THEschildkrote/armtracking/markers_A4.pdf

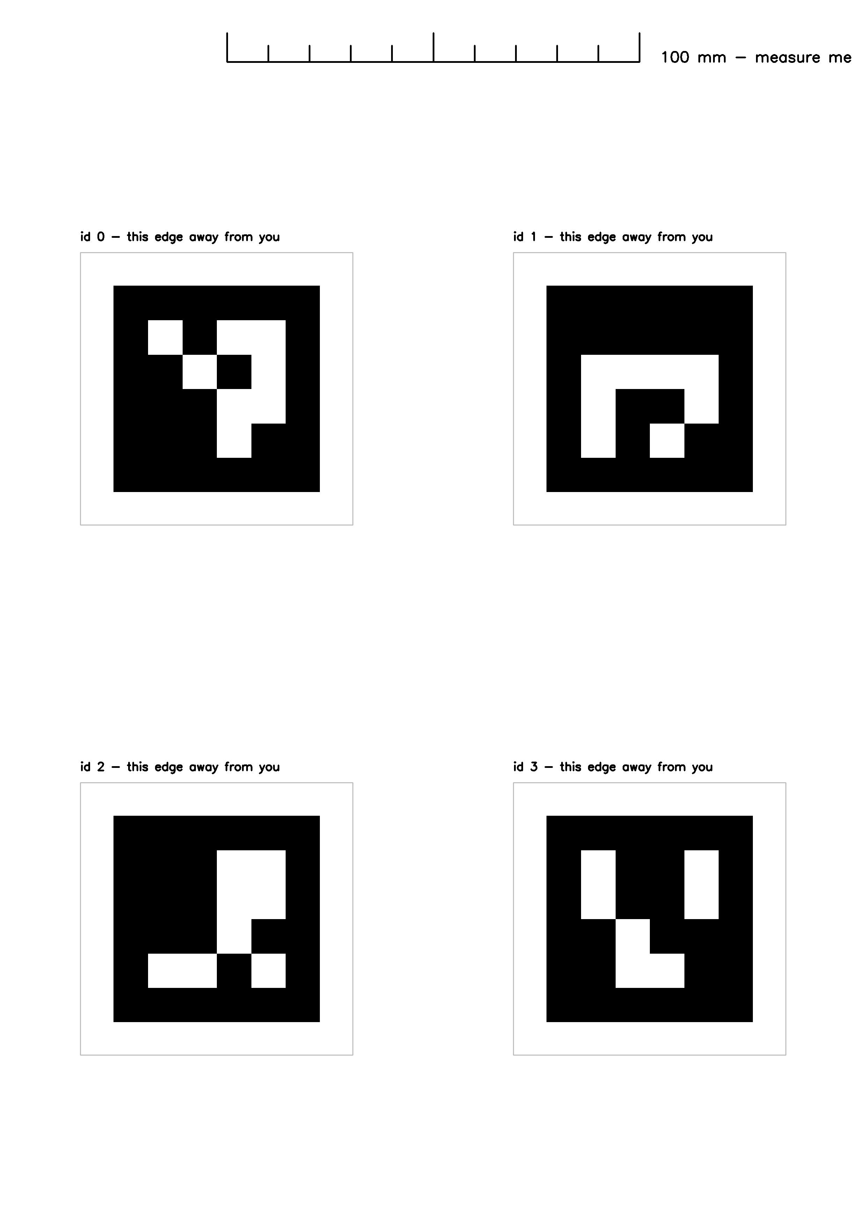
[picture p7: page 1]
