THEschildkrote/armtracking/data/2026-10-17/images/front_now.jpg

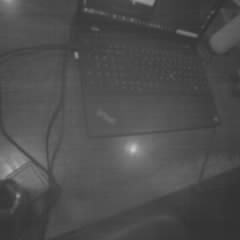
data/2026-10-17/images/front_now.jpg
