THEschildkrote/armtracking/data/2026-10-17/images/relay_eye.jpg

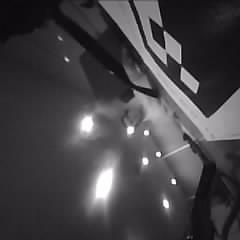
data/2026-10-17/images/relay_eye.jpg
