THEschildkrote/armtracking/data/2026-10-17/images/relay_wrist.jpg

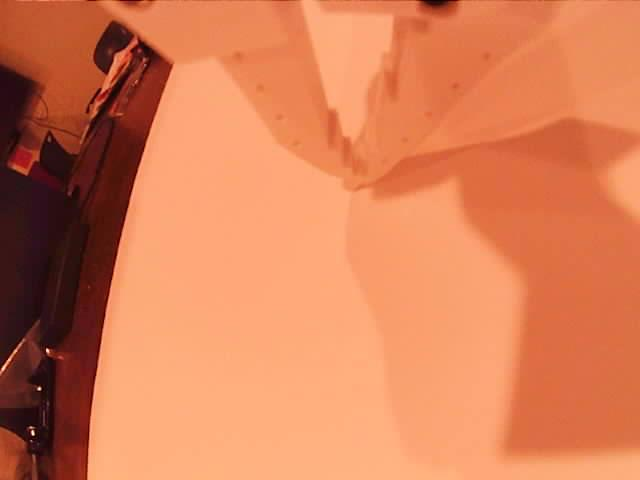
data/2026-10-17/images/relay_wrist.jpg
