THEschildkrote/armtracking/data/2026-10-17/images/side_ffmpeg.jpg

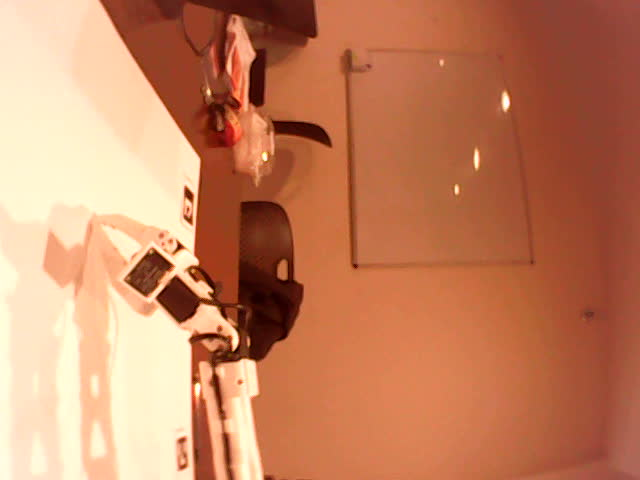
data/2026-10-17/images/side_ffmpeg.jpg
