THEschildkrote/armtracking/data/2026-10-17/images/side_live_objects.jpg

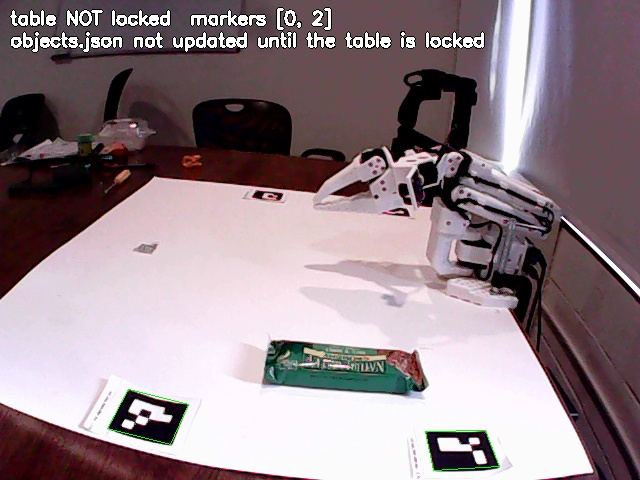
data/2026-10-17/images/side_live_objects.jpg
