THEschildkrote/armtracking/data/2026-10-17/images/side_reach_map.jpg

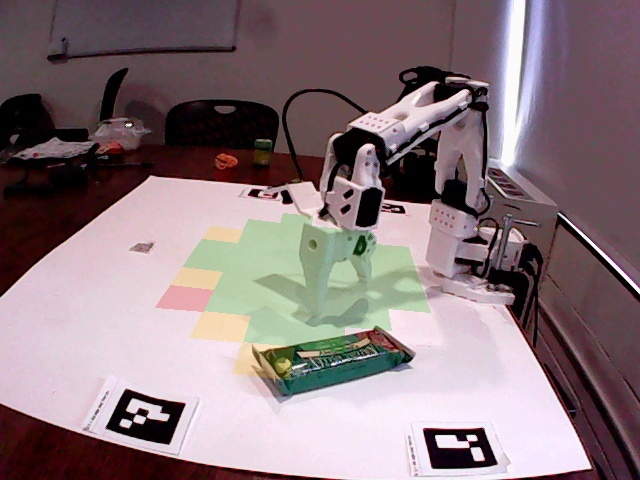
data/2026-10-17/images/side_reach_map.jpg
