THEschildkrote/armtracking/gaze/phone_target.png

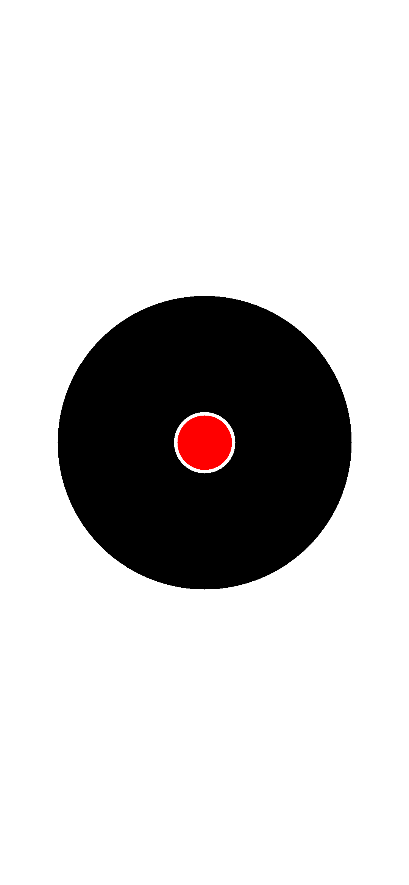
gaze/phone_target.png
