THEschildkrote/armtracking/output/figures/front_view.png

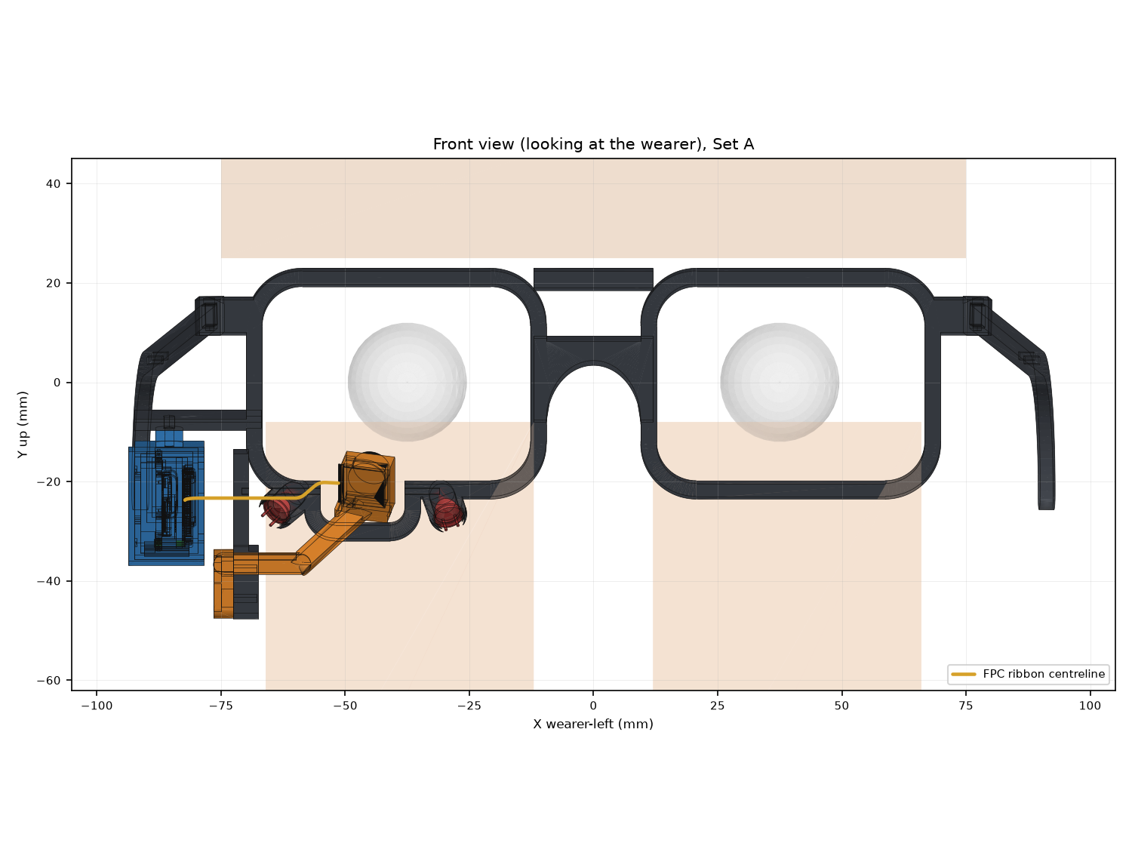
output/figures/front_view.png
