THEschildkrote/armtracking/output/figures/pivot_sweep_A.gif

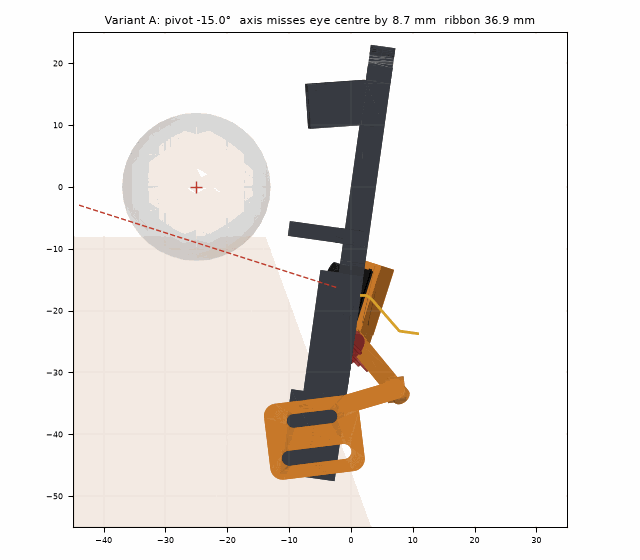
output/figures/pivot_sweep_A.gif
