THEschildkrote/armtracking/output/figures/side_view_A_dimensioned.png

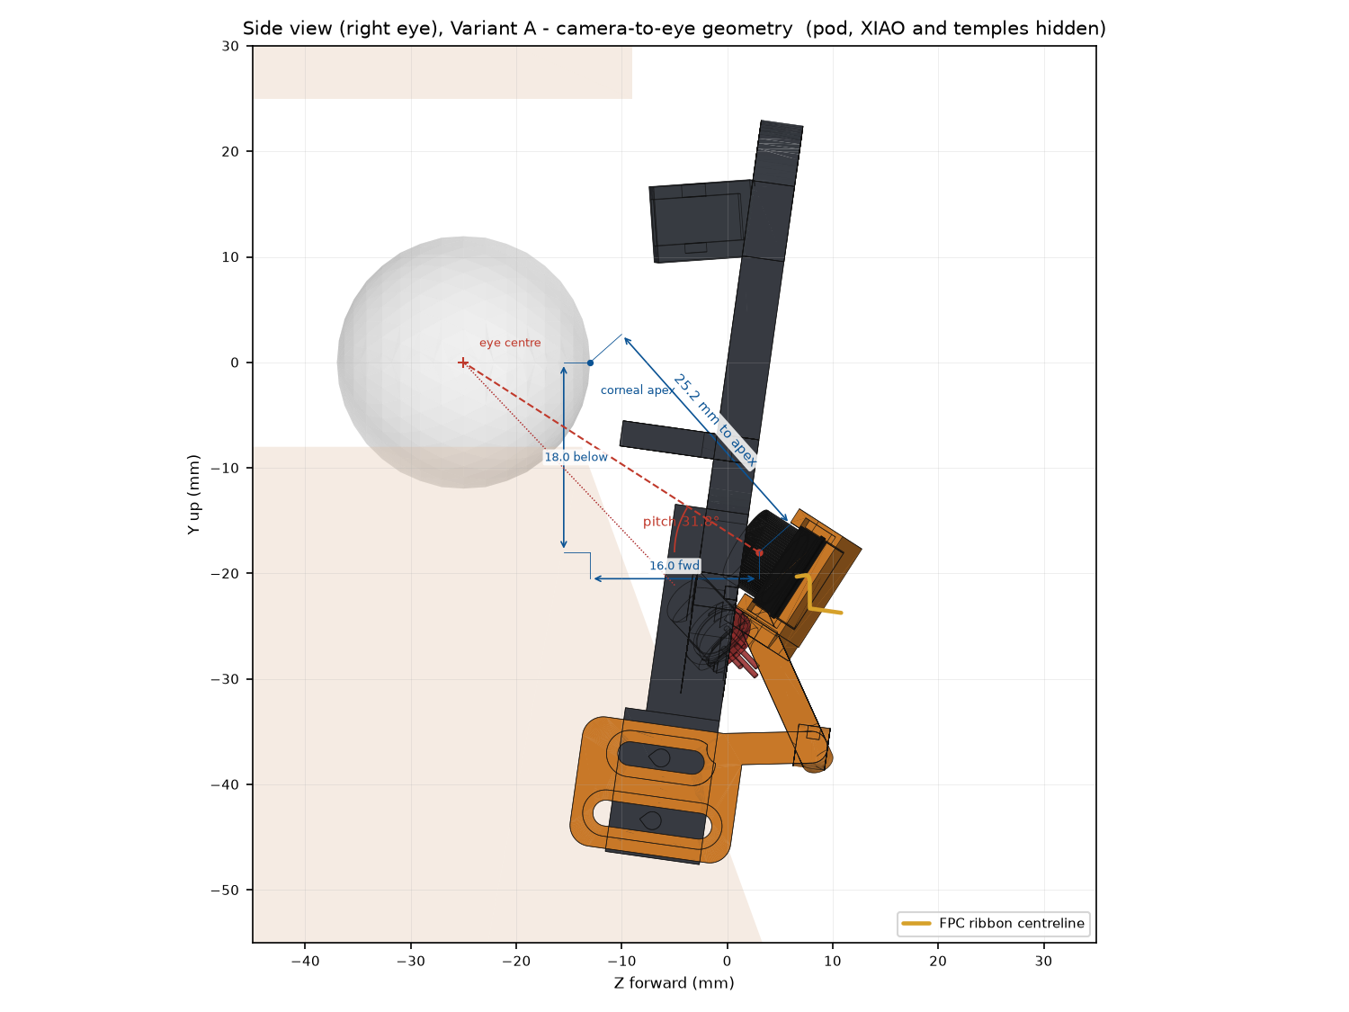
output/figures/side_view_A_dimensioned.png
