THEschildkrote/armtracking/output/figures/top_view.png

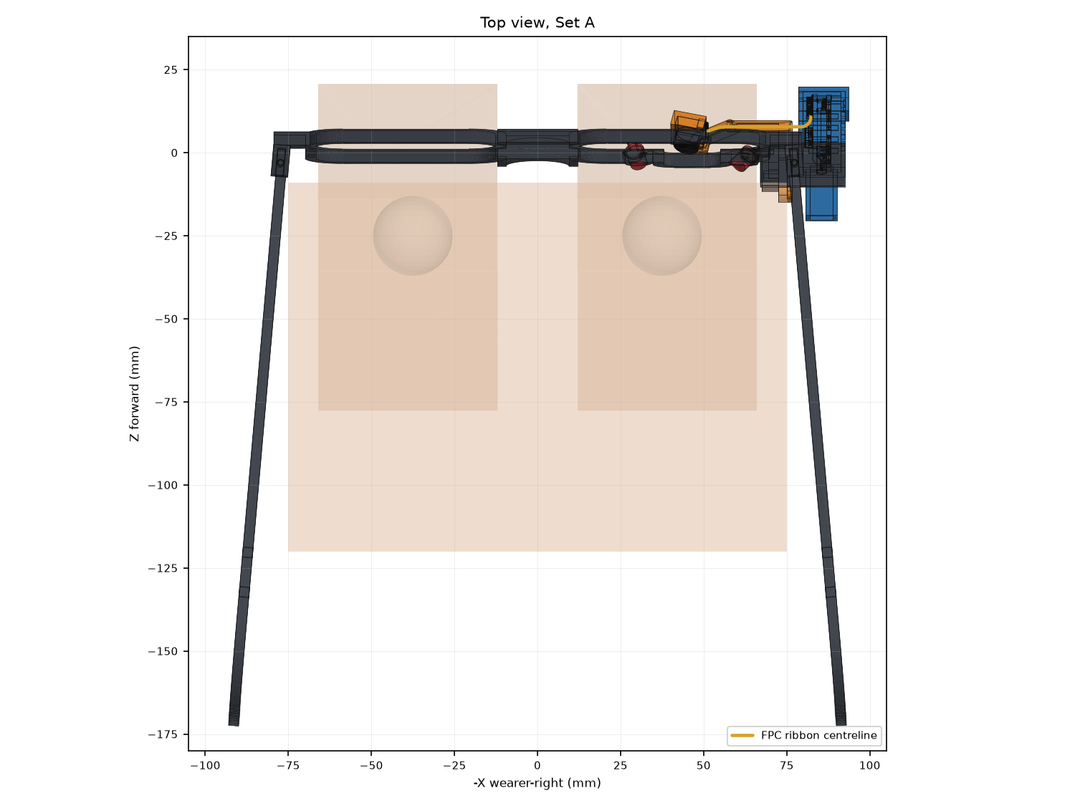
output/figures/top_view.png
