THEschildkrote/armtracking/output/figures/variant_comparison_A_vs_B.png

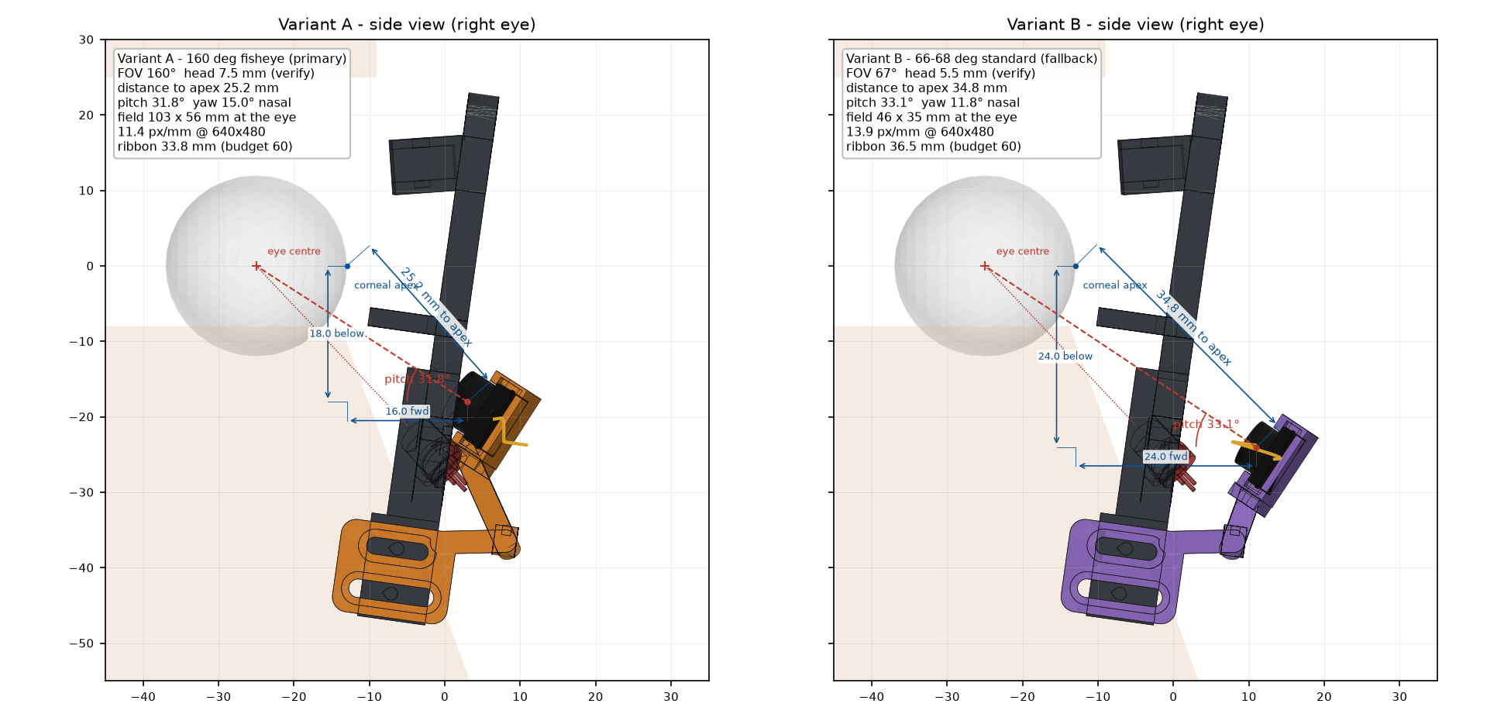
output/figures/variant_comparison_A_vs_B.png
