THEschildkrote/armtracking/output/assembly/eyetracker_set_B_assembly.step

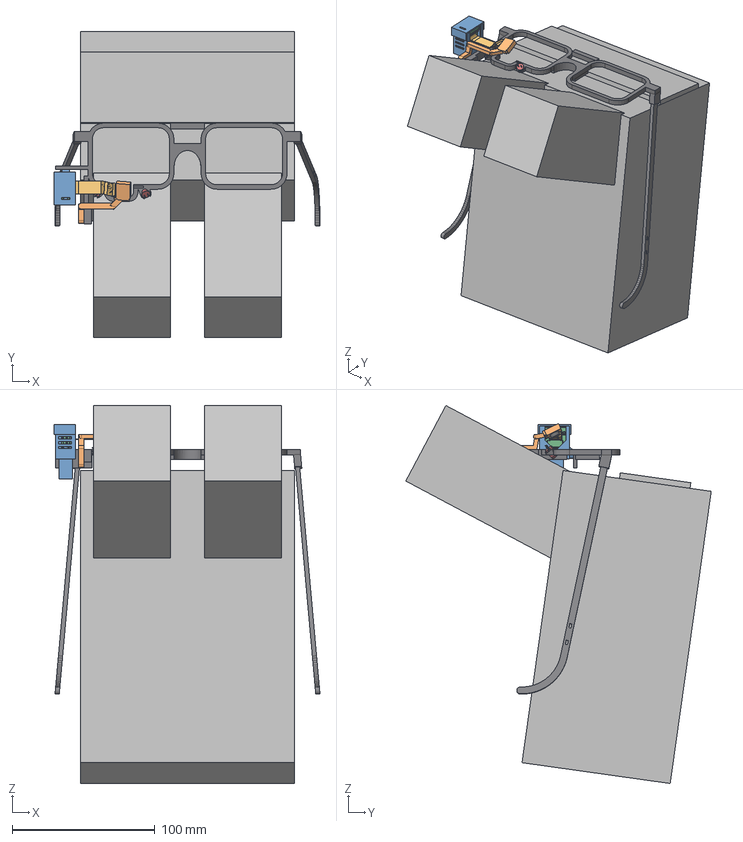
[picture p22: CAD file, 2026-10-17]
output/assembly/eyetracker_set_B_assembly.step
186.6 x 214.4 x 265.2 mm
front
temple_R
temple_L
pod_body
pod_lid
xiao_esp32s3_sense
ir_led_temporal
ir_led_nasal
stalk_B
camera_B
ribbon_B
eye_right
eye_left
cheek_right
cheek_left
brow
head
