THEschildkrote/armtracking/output/poses/variant_A_slot_fore_assembly.step

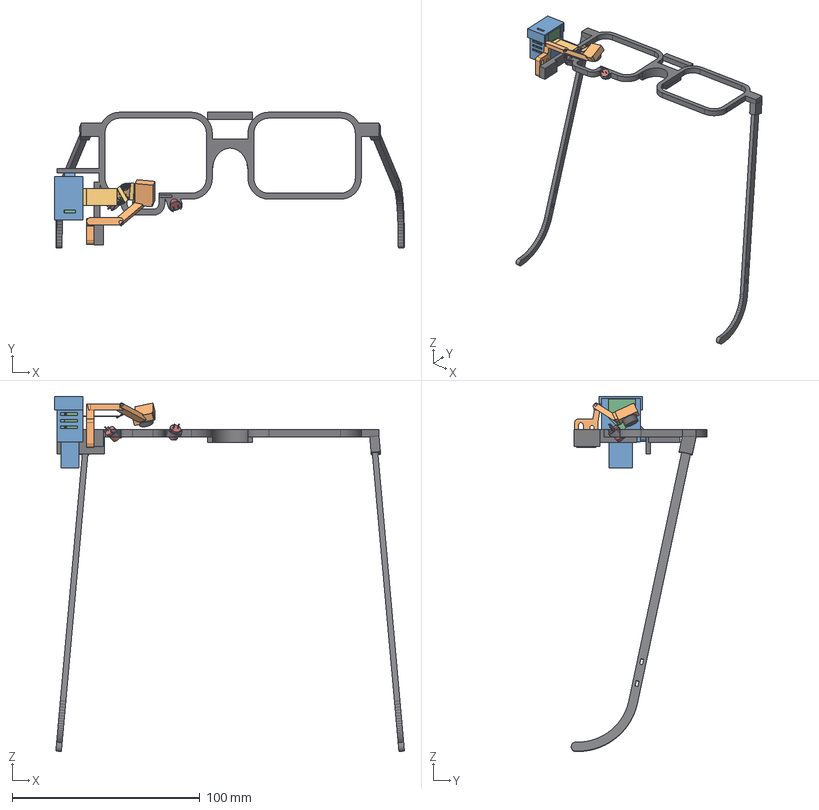
[picture p23: CAD file, 2026-10-17]
output/poses/variant_A_slot_fore_assembly.step
186.6 x 72.3 x 189.3 mm
front
temple_R
temple_L
pod_body
pod_lid
xiao_envelope_measured
ir_led_temporal
ir_led_nasal
stalk_A
camera_A
ribbon_A
