THEschildkrote/armtracking/output/print_orientation/pod_lid.step

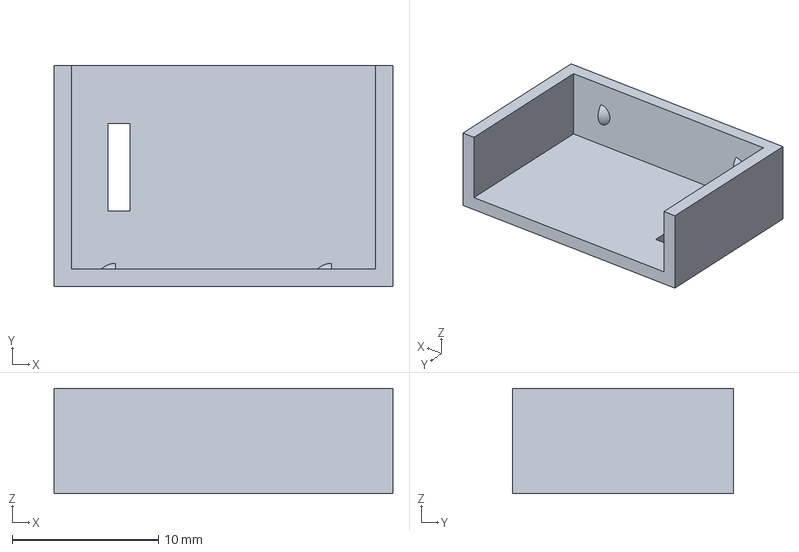
[picture p24: CAD file, 2026-10-17]
output/print_orientation/pod_lid.step
23.2 x 15.1 x 7.20 mm
