THEschildkrote/armtracking/output/print_sets/print_set_B_frame_plus_stalk_B.step

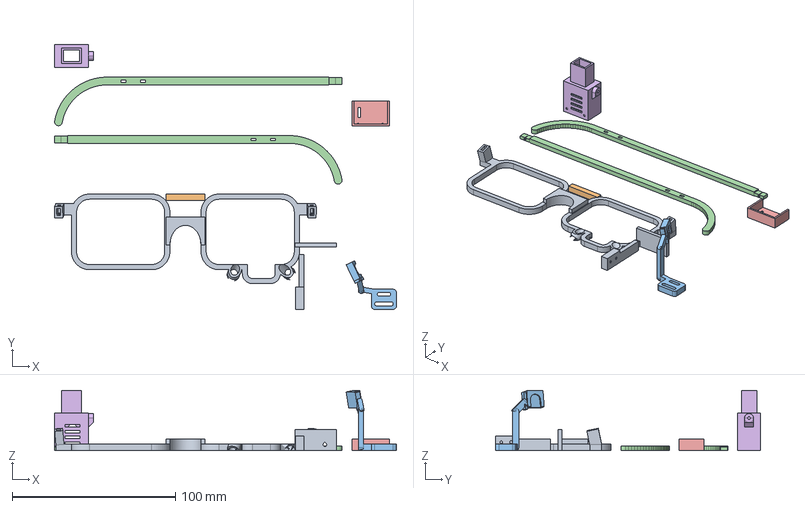
[picture p25: CAD file, 2026-10-17]
output/print_sets/print_set_B_frame_plus_stalk_B.step
209.6 x 162.3 x 37.1 mm
