THEschildkrote/armtracking/output/reference/camera_B_8p5_head_verify.step

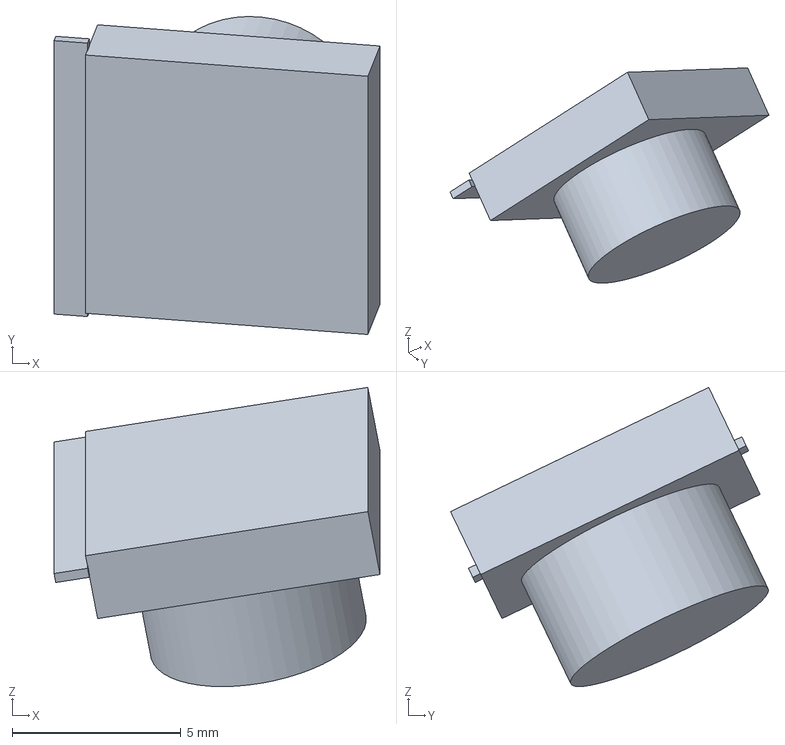
[picture p26: CAD file, 2026-10-17]
output/reference/camera_B_8p5_head_verify.step
9.67 x 9.43 x 8.88 mm
