THEschildkrote/armtracking/output/step/temple_left.step

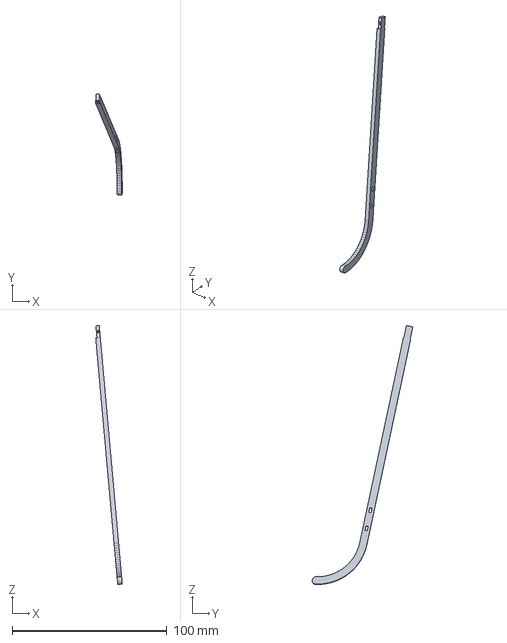
[picture p27: CAD file, 2026-10-17]
output/step/temple_left.step
17.2 x 65.0 x 167.3 mm
