THEschildkrote/armtracking/output/assembly/eyetracker_set_A_AS_WORN_world_frame_flat.step

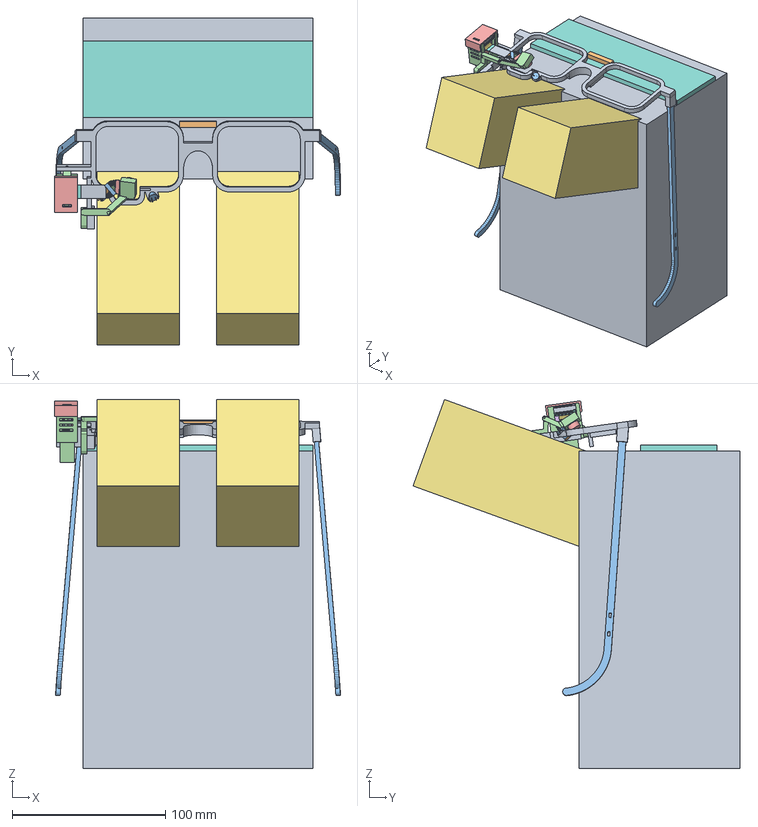
[picture p28: CAD file, 2026-10-17]
output/assembly/eyetracker_set_A_AS_WORN_world_frame_flat.step
186.6 x 213.3 x 240.7 mm
