THEschildkrote/armtracking/output/print_orientation/temple_right.step

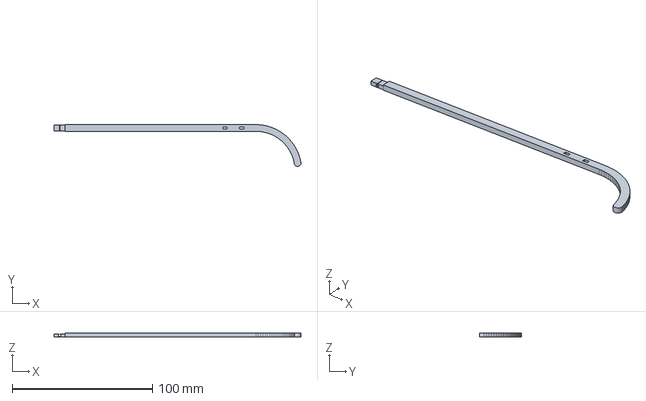
[picture p29: CAD file, 2026-10-17]
output/print_orientation/temple_right.step
176.2 x 29.8 x 3.00 mm
