THEschildkrote/armtracking/output/reference/xiao_esp32s3_sense_placed.step

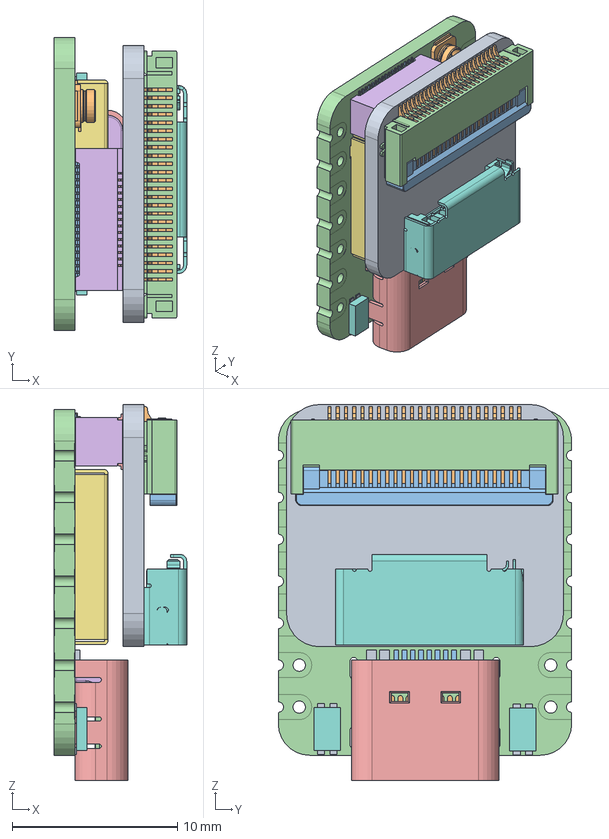
[picture p30: CAD file, 2026-10-17]
output/reference/xiao_esp32s3_sense_placed.step
8.03 x 17.8 x 22.8 mm
