THEschildkrote/armtracking/output/step/front.step

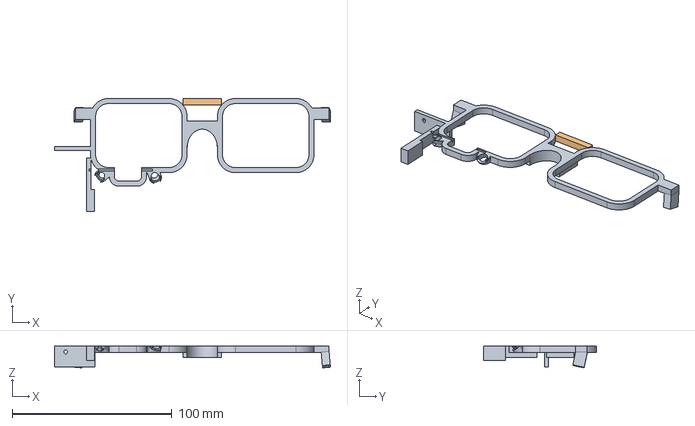
[picture p31: CAD file, 2026-10-17]
output/step/front.step
172.7 x 70.7 x 13.7 mm
