THEschildkrote/armtracking/output/reference/face_proxy.step

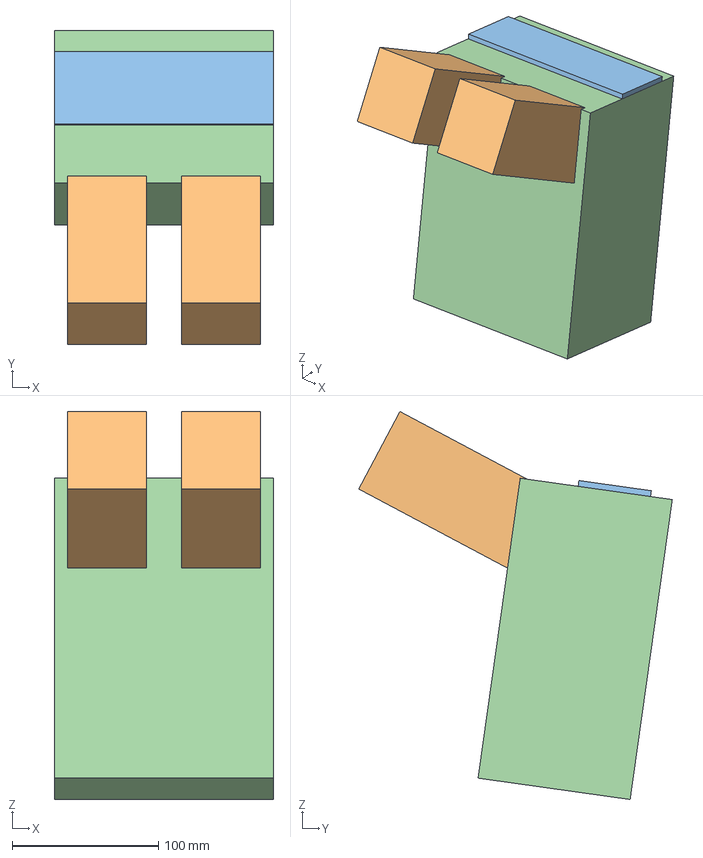
[picture p32: CAD file, 2026-10-17]
output/reference/face_proxy.step
150.0 x 214.4 x 265.2 mm
