THEschildkrote/armtracking/output/print_orientation/stalk_B.step

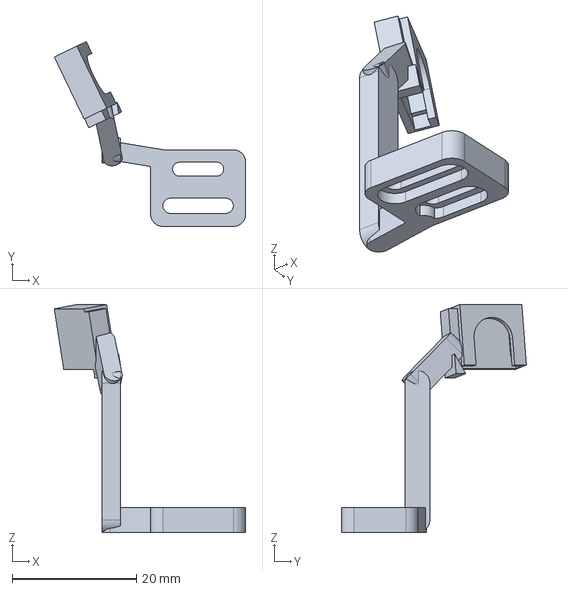
[picture p33: CAD file, 2026-10-17]
output/print_orientation/stalk_B.step
30.9 x 29.8 x 36.8 mm
