THEschildkrote/armtracking/output/reference/ir_led_nasal.step

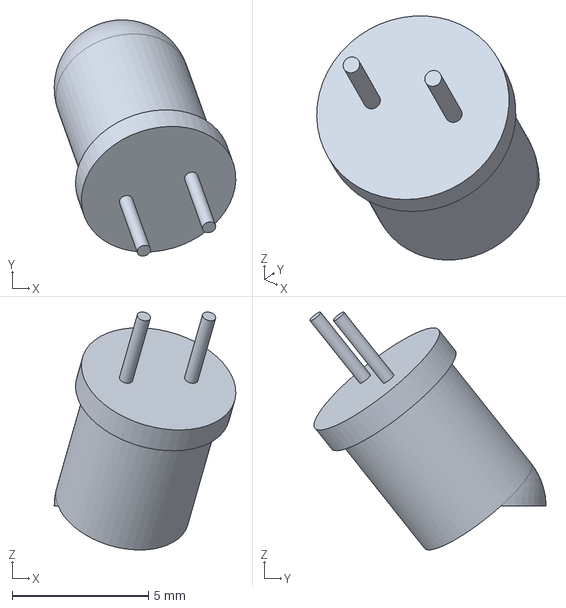
[picture p34: CAD file, 2026-10-17]
output/reference/ir_led_nasal.step
6.66 x 8.66 x 8.72 mm
