THEschildkrote/armtracking/output/step/pod_body.step

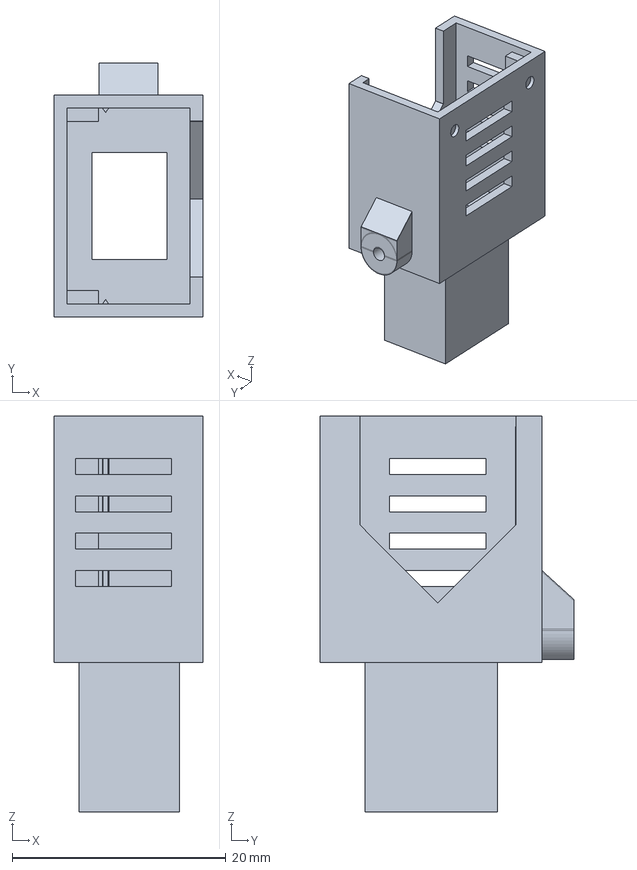
[picture p35: CAD file, 2026-10-17]
output/step/pod_body.step
13.9 x 23.8 x 37.1 mm
