THEschildkrote/armtracking/output/print_orientation/stalk_A.step

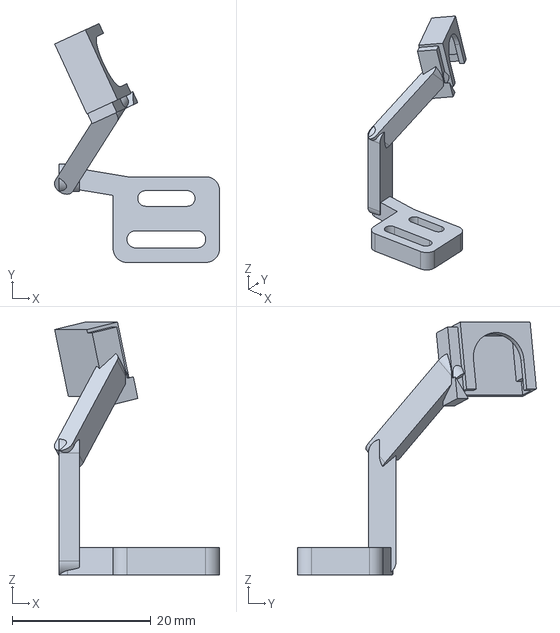
[picture p36: CAD file, 2026-10-17]
output/print_orientation/stalk_A.step
23.8 x 34.4 x 36.5 mm
