THEschildkrote/armtracking/output/reference/camera_A_8p5_head_verify.step

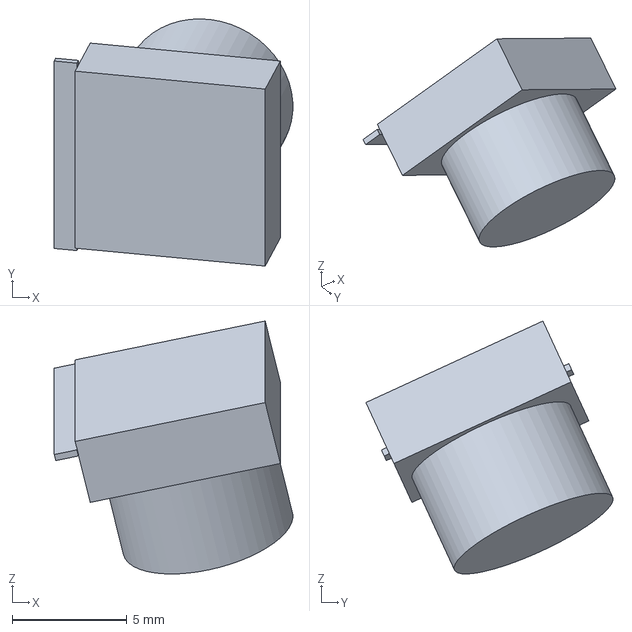
[picture p37: CAD file, 2026-10-17]
output/reference/camera_A_8p5_head_verify.step
10.4 x 10.8 x 11.0 mm
