THEschildkrote/armtracking/output/reference/ir_led_temporal.step

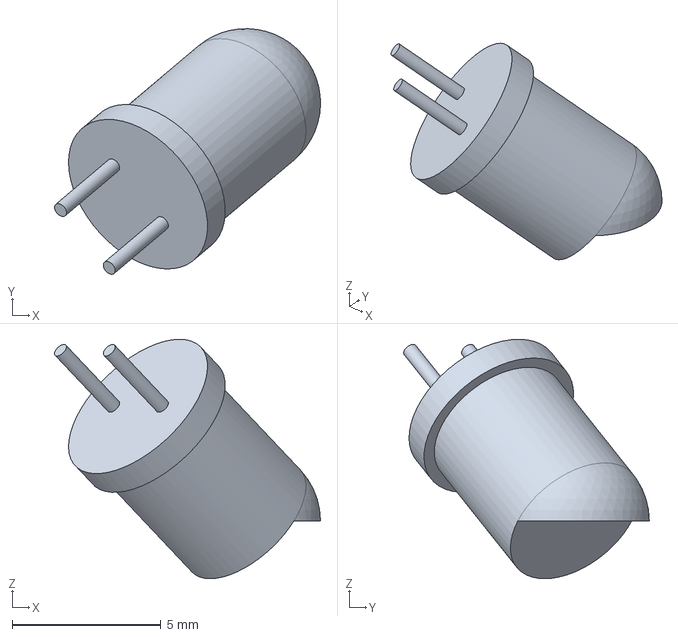
[picture p38: CAD file, 2026-10-17]
output/reference/ir_led_temporal.step
8.93 x 8.25 x 8.04 mm
