THEschildkrote/armtracking/(list of files, cad)

Other CAD files:
output/assembly/eyetracker_set_A_assembly.step
output/poses/variant_B_pitch_plus15_assembly.step
output/poses/variant_A_rest_assembly.step
output/poses/variant_A_slot_aft_assembly.step
output/poses/variant_B_slot_fore_assembly.step
output/poses/variant_A_pitch_plus15_assembly.step
output/poses/variant_B_rest_assembly.step
output/poses/variant_B_slot_aft_assembly.step
output/poses/variant_A_pitch_minus15_assembly.step
output/poses/variant_B_pitch_minus15_assembly.step
output/poses/variant_A_pitch_minus15_flat.step
output/print_sets/print_set_A_frame_plus_stalk_A.step
output/poses/variant_A_rest_flat.step
output/print_orientation/temple_left.step
output/step/pod_lid.step
output/poses/variant_B_slot_fore_flat.step
output/step/stalk_B.step
output/print_orientation/front.step
output/step/temple_right.step
output/print_orientation/pod_body.step
output/step/stalk_A.step
output/poses/variant_A_slot_aft_flat.step
output/poses/variant_B_slot_aft_flat.step
output/poses/variant_B_rest_flat.step
output/poses/variant_B_pitch_plus15_flat.step
output/poses/variant_A_pitch_plus15_flat.step
output/poses/variant_A_slot_fore_flat.step
output/poses/variant_B_pitch_minus15_flat.step
output/print_orientation/front.stl
output/print_orientation/pod_body.stl
output/print_orientation/pod_lid.stl
output/print_orientation/stalk_A.stl
output/print_orientation/stalk_B.stl
output/print_orientation/temple_left.stl
output/print_orientation/temple_right.stl
output/print_sets/print_set_A_frame_plus_stalk_A.3mf
output/print_sets/print_set_A_frame_plus_stalk_A.stl
output/print_sets/print_set_B_frame_plus_stalk_B.3mf
output/print_sets/print_set_B_frame_plus_stalk_B.stl
output/reference/camera_A_8p5_head_verify.stl
output/reference/camera_B_8p5_head_verify.stl
output/reference/ir_led_nasal.stl
output/reference/ir_led_temporal.stl
output/stl/front.stl
output/stl/pod_body.stl
output/stl/pod_lid.stl
output/stl/stalk_A.stl
output/stl/stalk_B.stl
output/stl/temple_left.stl
output/stl/temple_right.stl
