THEschildkrote/armtracking/data/2026-10-17/eye/eye_test2.csv

t | x | y | major | minor | angle | openness | valid | usable | closed | event
6997.3590 | 79.0669 | 136.7917 | 21.3990 | 13.5108 | 30.7226 | 1.0000 | True | True | False
6997.4060 | 78.8434 | 136.8720 | 20.6977 | 13.1784 | 31.2290 | 0.9680 | True | True | False
6997.4060 | 81.8382 | 146.1949 | 23.7130 | 17.5012 | 22.1686 | 1.4460 | True | True | False
6997.4210 | 81.8255 | 146.1092 | 23.8722 | 17.5394 | 21.0070 | 1.1955 | True | True | False
6997.4370 | 81.7311 | 146.0367 | 23.8096 | 17.6062 | 21.4837 | 1.0079 | True | True | False
6997.4530 | 81.5927 | 146.0416 | 23.1232 | 17.0712 | 20.7253 | 0.9764 | True | True | False
6997.4680 | 81.4909 | 145.9736 | 23.1173 | 16.8931 | 22.3746 | 0.9933 | True | True | False
6997.4840 | 81.4661 | 145.9062 | 23.0092 | 16.9314 | 22.7701 | 0.9900 | True | True | False
6997.5000 | 81.2097 | 145.8509 | 23.6803 | 17.4491 | 22.4473 | 1.0400 | True | True | False
6997.5150 | 81.0059 | 145.8432 | 23.1757 | 17.0288 | 22.2646 | 1.0033 | True | True | False
6997.5310 | 81.0019 | 145.8371 | 23.5690 | 17.1327 | 21.7366 | 1.0215 | True | True | False
6997.5620 | 80.9142 | 145.7630 | 23.1462 | 16.7661 | 22.4848 | 0.9718 | True | True | False
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
