THEschildkrote/armtracking/data/2026-10-17/eye/eye_test3.csv

t | x | y | major | minor | angle | openness | valid | darkness | contrast | usable | closed | reason | event
8142.4370 | 131.5956 | 149.5220 | 45.1208 | 38.5512 | 26.8076 | 1.0000 | True | 44.3139 | 33.3711 | True | False
8142.4680 | 129.0113 | 149.4195 | 37.4576 | 22.1554 | 164.4266 | 0.8067 | True | 40.1673 | 38.8118 | True | False
8142.4840 | 128.9439 | 149.8605 | 38.2120 | 21.4149 | 163.3448 | 0.9781 | True | 40.0075 | 37.4574 | True | False
8142.5000 | 129.0701 | 150.2715 | 36.3351 | 19.7302 | 163.5616 | 0.8580 | True | 38.0536 | 34.8426 | True | False
8142.5150 | 129.6575 | 149.2150 | 37.4632 | 23.6950 | 163.2965 | 1.0000 | True | 40.3815 | 37.8134 | True | False
8142.5310 | 129.4555 | 149.0293 | 37.0920 | 22.5241 | 165.1931 | 0.9702 | True | 40.0596 | 36.8789 | True | False
8142.5460 | 128.7756 | 149.4936 | 37.0882 | 21.6730 | 162.3112 | 1.0000 | True | 39.9495 | 38.0880 | True | False
8142.5620 | 129.7323 | 148.8392 | 36.8041 | 24.0763 | 164.1044 | 0.9985 | True | 40.7711 | 36.9212 | True | False
8142.5780 | 129.0967 | 149.2357 | 37.2390 | 21.8223 | 163.5638 | 0.9858 | True | 40.0913 | 37.3652 | True | False
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
