THEschildkrote/armtracking/data/2026-10-17/eye/eye_test4.csv

t | x | y | major | minor | angle | openness | valid | darkness | contrast | usable | closed | reason | event
19698.0150 | 81.7490 | 151.9781 | 30.4054 | 11.7621 | 90.3636 | 1.0000 | True | 21.0685 | 35.7659 | True | False
19698.0460 | 73.0177 | 115.0834 | 22.6169 | 9.3438 | 39.4361 | 0.8345 | True | 47.7416 | 63.8981 | False | False | jump
19698.0620 | 72.2645 | 115.5404 | 23.1815 | 9.1778 | 38.3834 | 1.0000 | True | 47.5912 | 65.7775 | True | False
19698.0780 | 72.0079 | 115.7619 | 22.8620 | 9.2963 | 38.2216 | 1.0000 | True | 47.2912 | 66.6978 | True | False
19698.0930 | 71.9375 | 115.8346 | 24.3021 | 9.6705 | 37.9391 | 1.0823 | True | 48.9091 | 69.8348 | True | False
19698.1090 | 71.8521 | 115.8105 | 24.4359 | 9.6396 | 37.7714 | 1.0517 | True | 48.4975 | 69.7797 | True | False
19698.1250 | 72.0015 | 115.8252 | 24.2169 | 9.8738 | 37.4469 | 1.0205 | True | 48.8090 | 69.3448 | True | False
19698.1560 | 71.8406 | 115.8570 | 24.4173 | 9.5861 | 38.1287 | 1.0044 | True | 48.6904 | 68.7237 | True | False
19698.1710 | 71.8521 | 115.8105 | 24.4359 | 9.6396 | 37.7714 | 1.0029 | True | 48.1878 | 69.0297 | True | False
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
