THEschildkrote/armtracking/data/2026-10-17/eye/eye_test5.csv

t | x | y | major | minor | angle | openness | valid | darkness | contrast | usable | closed | reason | event
19778.6250 | 74.1120 | 156.2607 | 26.3088 | 17.4430 | 169.4566 | 1.0000 | True | 67.7840 | 137.5513 | True | False
19778.6710 | 83.0663 | 131.6146 | 25.1779 | 18.8825 | 35.2241 | 1.0263 | True | 61.2799 | 124.8230 | False | False | jump
19778.6870 | 82.9202 | 131.6513 | 24.6241 | 18.0747 | 35.3524 | 0.9869 | True | 56.5984 | 124.7229 | True | False
19778.7030 | 82.8782 | 131.6465 | 24.6936 | 18.0395 | 36.1094 | 0.9949 | True | 57.1730 | 125.4366 | True | False
19778.7180 | 82.8328 | 131.7167 | 24.4116 | 18.0831 | 36.0623 | 0.9941 | True | 57.7216 | 125.0411 | True | False
19778.7340 | 82.8848 | 131.6141 | 24.6529 | 18.1328 | 34.6479 | 0.9993 | True | 57.4151 | 125.6390 | True | False
19778.7500 | 82.7740 | 131.4591 | 24.8288 | 18.6412 | 34.5770 | 1.0412 | True | 60.3516 | 125.2063 | True | False
19778.7650 | 82.4880 | 130.3782 | 24.8837 | 18.4474 | 37.0534 | 1.0242 | True | 64.4016 | 120.1818 | True | False
19778.7810 | 82.1020 | 129.9019 | 24.7701 | 17.9163 | 34.9767 | 0.9853 | True | 62.0110 | 119.4739 | True | False
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
