THEschildkrote/armtracking/data/2026-10-17/eye/eye_test6.csv

t | x | y | major | minor | angle | openness | valid | darkness | contrast | usable | closed | reason | event
19923.7030 | 82.5751 | 142.8896 | 23.8653 | 15.2793 | 25.7086 | 1.0000 | True | 66.0649 | 119.2034 | True | False
19923.7340 | 84.6817 | 144.8342 | 22.3733 | 15.7529 | 26.9639 | 0.9743 | True | 61.4418 | 126.6579 | True | False
19923.7500 | 84.7354 | 145.0489 | 21.8273 | 15.0267 | 25.4932 | 0.9358 | True | 56.8982 | 126.5222 | True | False
19923.7650 | 84.7414 | 145.1497 | 21.5995 | 14.9411 | 25.4045 | 0.9591 | True | 56.4469 | 126.5904 | True | False
19923.7810 | 84.8798 | 145.1345 | 21.7392 | 15.1960 | 25.6218 | 1.0000 | True | 57.2698 | 125.2050 | True | False
19923.7960 | 84.8529 | 145.1893 | 21.5590 | 15.2334 | 25.6616 | 0.9990 | True | 57.4748 | 126.2289 | True | False
19923.8120 | 84.9267 | 145.3118 | 21.5128 | 14.9221 | 26.1497 | 0.9780 | True | 56.5275 | 125.8807 | True | False
19923.8280 | 84.8527 | 145.3154 | 21.3761 | 15.1175 | 26.8711 | 0.9739 | True | 55.5240 | 126.0034 | True | False
19923.8430 | 84.9250 | 145.3022 | 21.5232 | 14.9316 | 25.9755 | 0.9879 | True | 56.0183 | 126.0667 | True | False
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
