THEschildkrote/armtracking/gaze/calibrate.py

"""Gaze calibration: pupil (eye camera) -> front-camera pixels, using on-screen targets.

A full-screen window shows a black disc at 9 spots on the laptop screen. You
keep your head still and look at the red dot in the middle of each one; the
front camera on the glasses finds the disc (gaze/target.py - ArUco markers are
too small to decode at its 240x240), the eye camera finds the pupil, and the
pairs are fitted (gaze/mapper.py). No printed targets needed.

Table mode (--mode table) calibrates where the demo happens: a phone showing
gaze/phone_target.png (black disc, red dot) lies on the board; you look at its
red dot and press SPACE, then move the phone to the next spot. Spread ~9 spots
over the whole work area. The laptop window stays dark so it isn't mistaken for
the phone.

Usage (from the armproject folder, glasses on, laptop on the hotspot):
    calib.cmd                                   # screen mode: eye camera 3, front camera Board B
    calib.cmd --mode table                      # phone on the table
    calib.cmd --scene 1                         # a USB camera as the front camera

Keys (screen): SPACE start / continue, r redo the last point, Esc quit.
Keys (table):  SPACE record this spot, r remove the last spot, f finish and fit (>= 6 spots), Esc quit.
Result: gaze/calib.json, plus the leave-one-out error in front-camera pixels.
"""

from __future__ import annotations

import argparse
import ctypes
import time
from pathlib import Path

import cv2
import numpy as np

from eye.detector import PupilDetector
from eye.live import load_config
from eye.validity import EyeValidity
from gaze.capture import CameraThread
from gaze.mapper import CALIB_PATH, fit
from gaze.target import find_target, target_disc

WINDOW = "gaze calibration"
SETTLE_S = 1.0  # time to move the eyes to the new target
COLLECT_S = 1.2
MIN_EYE = 15  # usable pupil samples needed per point
MIN_SCENE = 3  # front-camera detections needed per point
EYE_STEADY_PX = 4.0  # pupil samples within this of their median count as "on the dot"
SCENE_STEADY_PX = 8.0  # target detections within this of their median count as the same target
STEADY_SHARE = 0.6  # at least this share of each must be steady, or the spot is redone
DISAGREE_PX = 30.0  # a new spot this far from what the earlier spots predict is flagged
last_reject = ""  # why the last collect_point returned None, for the on-screen message


def _steady(points: list, radius: float) -> tuple[np.ndarray | None, float]:
    """Median of the points that sit near their overall median, and the share that does."""
    a = np.array(points, float)
    med = np.median(a, axis=0)
    near = np.linalg.norm(a - med, axis=1) <= radius
    return (np.median(a[near], axis=0) if near.any() else None), float(near.mean())


def predict_error(pupil_pts: list, scene_pts: list, pupil, scene) -> float:
    """How far `scene` is from where an affine fit of the earlier spots puts `pupil` (front-camera px)."""
    p, sc = np.array(pupil_pts, float), np.array(scene_pts, float)
    m = np.linalg.lstsq(np.c_[p, np.ones(len(p))], sc, rcond=None)[0]
    return float(np.linalg.norm(np.r_[pupil, 1.0] @ m - scene))


def running_error(pupil_pts: list, scene_pts: list) -> float:
    """Leave-one-out RMS of an affine fit over the spots so far (front-camera px)."""
    errs = [predict_error(pupil_pts[:i] + pupil_pts[i + 1:], scene_pts[:i] + scene_pts[i + 1:], pupil_pts[i], scene_pts[i])
            for i in range(len(pupil_pts))]
    return float(np.sqrt(np.mean(np.square(errs))))
GRID = [(0.5, 0.5), (0.2, 0.2), (0.5, 0.2), (0.8, 0.2), (0.8, 0.5), (0.8, 0.8), (0.5, 0.8), (0.2, 0.8), (0.2, 0.5)]  # clear of the bezel


def screen_size() -> tuple[int, int]:
    try:
        user32 = ctypes.windll.user32
        user32.SetProcessDPIAware()
        return user32.GetSystemMetrics(0), user32.GetSystemMetrics(1)
    except Exception:
        return 1920, 1080




def collect_point(eye_cam, scene_cam, detector, validity, seconds: float, phone: bool = False):
    """Gather usable pupil positions and target detections for `seconds`; returns their medians or None."""
    eye_buf, scene_buf = [], []
    eye_count = scene_count = 0
    end = time.monotonic() + seconds
    while time.monotonic() < end:
        frame, _, count = eye_cam.latest()
        if frame is not None and count != eye_count:
            eye_count = count
            state, _ = validity.update(detector.process(frame, time.monotonic()))
            if state.usable:
                eye_buf.append((state.sample.x, state.sample.y))
        frame, _, count = scene_cam.latest()
        if frame is not None and count != scene_count:
            scene_count = count
            centre = find_target(frame, phone=phone)
            if centre is not None:
                scene_buf.append(centre)
        cv2.waitKey(1)
    global last_reject
    if len(eye_buf) < MIN_EYE or len(scene_buf) < MIN_SCENE:
        last_reject = f"not enough data ({len(eye_buf)} eye, {len(scene_buf)} target samples)"
        return None, len(eye_buf), len(scene_buf)
    # The pupil and the target must each hold still: a median over a glance or a stray detection is a bad spot.
    pupil, eye_share = _steady(eye_buf, EYE_STEADY_PX)
    target, scene_share = _steady(scene_buf, SCENE_STEADY_PX)
    if eye_share < STEADY_SHARE:
        last_reject = f"your eye wasn't steady on the dot ({eye_share:.0%} steady)"
        return None, len(eye_buf), len(scene_buf)
    if scene_share < STEADY_SHARE:
        last_reject = f"the target jumped around ({scene_share:.0%} steady) - keep the phone still and in view"
        return None, len(eye_buf), len(scene_buf)
    last_reject = ""
    return (pupil, target), len(eye_buf), len(scene_buf)


def run_table(args, detector, validity, eye_cam, scene_cam) -> None:
    """Phone-on-the-table calibration: user places the phone, looks at its dot, presses SPACE."""
    window = "table calibration"
    cv2.namedWindow(window, cv2.WINDOW_NORMAL)
    cv2.resizeWindow(window, 760, 860)
    pupil_pts, scene_pts = [], []
    message, eye_count = "Put the phone on the first spot, look at its red dot, press SPACE.", 0
    eye_ok = False
    logs = Path(__file__).resolve().parents[1] / "logs"
    logs.mkdir(exist_ok=True)
    last_snap, eye_hits, seen_hits, frames = 0.0, 0, 0, 0  # a status copy others can read while this holds the cameras
    while True:
        frame, _, count = eye_cam.latest()
        if frame is not None and count != eye_count:
            eye_count = count
            state, _ = validity.update(detector.process(frame, time.monotonic()))
            eye_ok = state.usable
        front, _, _ = scene_cam.latest()
        canvas = np.zeros((860, 760, 3), np.uint8)  # dark, so the laptop screen never looks like the phone
        if front is not None:
            view = front if front.ndim == 3 else cv2.cvtColor(front, cv2.COLOR_GRAY2BGR)
            s = 720 / max(view.shape[:2])
            view = cv2.resize(view, None, fx=s, fy=s)
            for u, v in scene_pts:  # spots recorded so far
                cv2.circle(view, (int(u * s), int(v * s)), 6, (0, 200, 255), 2)
            centre = find_target(front, phone=True)
            if centre:
                cv2.circle(view, (int(centre[0] * s), int(centre[1] * s)), 14, (0, 255, 0), 2)
            canvas[20 : 20 + view.shape[0], 20 : 20 + view.shape[1]] = view
        else:
            centre = None
        status = f"eye: {'OK' if eye_ok else 'NO PUPIL'}   phone target: {'seen' if centre else 'not seen'}   spots: {len(pupil_pts)}"
        cv2.putText(canvas, status, (20, 770), cv2.FONT_HERSHEY_SIMPLEX, 0.6, (0, 255, 0) if eye_ok and centre else (0, 0, 255), 2)
        cv2.putText(canvas, message, (20, 805), cv2.FONT_HERSHEY_SIMPLEX, 0.5, (230, 230, 230), 1)
        cv2.putText(canvas, "SPACE record   r remove last   f finish & fit   Esc quit", (20, 840),
                    cv2.FONT_HERSHEY_SIMPLEX, 0.5, (160, 160, 160), 1)
        cv2.imshow(window, canvas)
        frames, eye_hits, seen_hits = frames + 1, eye_hits + eye_ok, seen_hits + bool(centre)
        if time.monotonic() - last_snap > 1.0:
            (logs / "calib_status.txt").write_text(
                f"{status}\nlast second: eye OK {100 * eye_hits / max(frames, 1):.0f}%, target seen "
                f"{100 * seen_hits / max(frames, 1):.0f}%\n{message}\n")
            cv2.imwrite(str(logs / "calib_view.jpg"), canvas)
            if frame is not None:
                cv2.imwrite(str(logs / "calib_eye.jpg"), frame)
            last_snap, eye_hits, seen_hits, frames = time.monotonic(), 0, 0, 0
        key = cv2.waitKey(1) & 0xFF
        if key == 27:
            return
        if key == ord(" "):
            time.sleep(0.4)  # let the eyes settle on the dot
            result, n_eye, n_front = collect_point(eye_cam, scene_cam, detector, validity, COLLECT_S, phone=True)
            if result is None:
                message = f"Spot not recorded: {last_reject}. Hold still on the dot and press SPACE again."
            else:
                off = predict_error(pupil_pts, scene_pts, result[0], result[1]) if len(pupil_pts) >= 4 else 0.0
                pupil_pts.append(result[0])
                scene_pts.append(result[1])
                fit_note = f"  Fit so far: {running_error(pupil_pts, scene_pts):.0f}px." if len(pupil_pts) >= 5 else ""
                if off > DISAGREE_PX:
                    message = (f"Spot {len(pupil_pts)} disagrees with the others by {off:.0f}px - press r to drop it "
                               f"(or keep it if the first spots were the bad ones).{fit_note}")
                else:
                    message = f"Spot {len(pupil_pts)} recorded. Move the phone somewhere new.{fit_note}"
                print(f"spot {len(pupil_pts)}: pupil {result[0].round(1)}  front {result[1].round(1)}  ({n_eye} eye / {n_front} phone)")
        elif key == ord("r") and pupil_pts:
            pupil_pts.pop(), scene_pts.pop()
            message = f"Removed the last spot ({len(pupil_pts)} left)."
        elif key == ord("f"):
            if len(pupil_pts) < 6:
                message = f"Need at least 6 spots ({len(pupil_pts)} so far)."
                continue
            calib = fit(np.array(pupil_pts), np.array(scene_pts), (front.shape[1], front.shape[0]))
            calib.save()
            message = (f"Saved: {len(pupil_pts)} spots, {'quadratic' if calib.quadratic else 'affine'} fit, "
                       f"error RMS {calib.loo_rms_px:.1f}px worst {calib.loo_worst_px:.1f}px. Esc to close.")
            print(message)


def main() -> None:
    parser = argparse.ArgumentParser()
    parser.add_argument("--eye", default="auto", help="Eye camera number, or auto (Board A by name)")
    parser.add_argument("--scene", default="auto", help="Front camera URL or number, or auto (Board B on the hotspot)")
    parser.add_argument("--mode", choices=["screen", "table"], default="screen")
    parser.add_argument("--marker", type=float, default=0.22, help="Target disc size as a fraction of screen height")
    args = parser.parse_args()

    if args.mode == "table":
        detector, validity = PupilDetector(load_config()), EyeValidity()
        eye_cam, scene_cam = CameraThread(args.eye, "eye"), CameraThread(args.scene, "front")
        try:
            run_table(args, detector, validity, eye_cam, scene_cam)
        finally:
            eye_cam.close()
            scene_cam.close()
            cv2.destroyAllWindows()
        return

    sw, sh = screen_size()
    msize = int(sh * args.marker)
    marker = target_disc(msize)
    detector = PupilDetector(load_config())
    validity = EyeValidity()

    eye_cam = CameraThread(args.eye, "eye")
    scene_cam = CameraThread(args.scene, "front")
    cv2.namedWindow(WINDOW, cv2.WINDOW_NORMAL)
    cv2.setWindowProperty(WINDOW, cv2.WND_PROP_FULLSCREEN, cv2.WINDOW_FULLSCREEN)

    eye_count = scene_count = 0
    eye_ok = scene_seen = False
    scene_size = (0, 0)
    pupil_pts, scene_pts = [], []
    i, phase, phase_t = 0, "intro", time.monotonic()
    eye_buf, scene_buf, retries = [], [], 0
    result_lines: list[str] = []
    from collections import Counter

    eye_why: Counter = Counter()  # why eye frames weren't usable during this point (printed on failure)
    logs = Path(__file__).resolve().parents[1] / "logs"
    logs.mkdir(exist_ok=True)

    try:
        while True:
            now = time.monotonic()
            frame, _, count = eye_cam.latest()
            if frame is not None and count != eye_count:
                eye_count = count
                state, _ = validity.update(detector.process(frame, now))
                eye_ok = state.usable
                if phase == "collect" and state.usable:
                    eye_buf.append((state.sample.x, state.sample.y))
                elif phase == "collect":
                    eye_why[state.reason or "?"] += 1
                if phase == "collect" and len(eye_buf) + sum(eye_why.values()) == 20:
                    cv2.imwrite(str(logs / f"calib_point{i + 1}_eye.jpg"), frame)
            frame, _, count = scene_cam.latest()
            if frame is not None and count != scene_count:
                scene_count = count
                scene_size = (frame.shape[1], frame.shape[0])
                centre = find_target(frame)
                scene_seen = centre is not None
                if scene_seen and phase == "collect":
                    scene_buf.append(np.array(centre))

            # Phase changes
            if phase == "settle" and now - phase_t >= SETTLE_S:
                phase, phase_t, eye_buf, scene_buf = "collect", now, [], []
                eye_why = Counter()
            elif phase == "collect" and now - phase_t >= COLLECT_S:
                if len(eye_buf) >= MIN_EYE and len(scene_buf) >= MIN_SCENE:
                    pupil_pts.append(np.median(np.array(eye_buf), axis=0))
                    scene_pts.append(np.median(np.array(scene_buf), axis=0))
                    print(f"point {i + 1}/{len(GRID)}: pupil {pupil_pts[-1].round(1)}  front {scene_pts[-1].round(1)}  "
                          f"({len(eye_buf)} eye / {len(scene_buf)} front samples)")
                    i, retries = i + 1, 0
                else:
                    print(f"point {i + 1}: not enough data ({len(eye_buf)} eye, {len(scene_buf)} front) - retrying"
                          f"   eye rejected because: {dict(eye_why.most_common(3))}")
                    retries += 1
                    if retries > 2:
                        print(f"point {i + 1}: skipped")
                        i, retries = i + 1, 0
                if i >= len(GRID):
                    phase = "done"
                    if len(pupil_pts) >= 3:
                        calib = fit(np.array(pupil_pts), np.array(scene_pts), scene_size)
                        calib.save()
                        result_lines = [
                            f"Saved {CALIB_PATH.name}: {len(pupil_pts)} points",
                            f"Leave-one-out error: RMS {calib.loo_rms_px:.1f} px, worst {calib.loo_worst_px:.1f} px"
                            f" (front camera {scene_size[0]}x{scene_size[1]})",
                        ]
                    else:
                        result_lines = [f"Only {len(pupil_pts)} usable points - check both cameras and try again."]
                    for line in result_lines:
                        print(line)
                else:
                    phase, phase_t = "settle", now

            # Draw
            canvas = np.full((sh, sw, 3), 255, np.uint8)
            if phase in ("settle", "collect"):
                cx = min(max(int(GRID[i][0] * sw), msize // 2), sw - msize // 2)  # keep the disc on screen
                cy = min(max(int(GRID[i][1] * sh), msize // 2), sh - msize // 2)
                x0, y0 = cx - msize // 2, cy - msize // 2
                canvas[y0 : y0 + msize, x0 : x0 + msize] = marker
                if phase == "collect":
                    cv2.circle(canvas, (cx, cy), msize // 2 + 20, (0, 180, 0), 4)
            lines = {
                "intro": ["Gaze calibration - keep your head still.", "Look at the RED DOT in the middle of each square.",
                          "SPACE to start, Esc to quit."],
                "done": result_lines + ["SPACE / Esc to close."],
            }.get(phase, [f"Point {i + 1}/{len(GRID)} - look at the red dot"])
            for k, line in enumerate(lines):
                cv2.putText(canvas, line, (40, 60 + 45 * k), cv2.FONT_HERSHEY_SIMPLEX, 1.1, (40, 40, 40), 2)
            status = f"eye: {'OK' if eye_ok else 'NO PUPIL'}   front camera: {'sees target' if scene_seen else 'no target'}"
            cv2.putText(canvas, status, (40, sh - 40), cv2.FONT_HERSHEY_SIMPLEX, 0.9,
                        (0, 150, 0) if eye_ok and (scene_seen or phase in ("intro", "done")) else (0, 0, 200), 2)
            cv2.imshow(WINDOW, canvas)

            key = cv2.waitKey(1) & 0xFF
            if key == 27:
                break
            if key == ord(" "):
                if phase == "intro":
                    phase, phase_t = "settle", time.monotonic()
                elif phase == "done":
                    break
            elif key == ord("r") and phase in ("settle", "collect") and pupil_pts:
                pupil_pts.pop(), scene_pts.pop()
                i, phase, phase_t = max(i - 1, 0), "settle", time.monotonic()
    finally:
        eye_cam.close()
        scene_cam.close()
        cv2.destroyAllWindows()


if __name__ == "__main__":
    main()
