THEschildkrote/armtracking/(commit log)

2026-10-17 Add eye-tracking glasses CAD output
    Parametric CadQuery build output for the Pupil-Core-style eye-tracking frame
    (XIAO ESP32-S3 Sense pod, OV2640 IR camera on stalk A 160 deg / stalk B 67 deg,
    2x 850 nm LEDs in the lower rim).
    - step/, stl/: every printable part in the design frame (Y up, Z forward,
    X = wearer's left), editable in Fusion
    - print_orientation/, print_sets/: parts laid on the bed; set A and set B each
    fit one 220 x 220 bed (STEP/STL/3MF)
    - poses/: rest, +-15 deg pivot and both slot ends, flat + component-tree STEP
    - assembly/: named component trees for set A and set B, plus an as-worn copy
    - reference/: placed XIAO model, parametric camera heads (verify by caliper),
    LEDs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
    [camera_A_8p5_head_verify.step, camera_A_8p5_head_verify.stl, camera_B_8p5_head_verify.step, camera_B_8p5_head_verify.stl, eyetracker_set_A_AS_WORN_world_frame_flat.step, eyetracker_set_A_assembly.step, eyetracker_set_B_assembly.step, face_proxy.step]
2026-10-17 Add hardware pipeline: eye tracking, gaze mapping, arm tooling
    Eye side: dark-pupil detector, blink/validity logic with long/double blink
    commands, live viewer; gaze calibration from on-screen ArUco targets via the
    head-mounted front camera, per-frame table homography, fixations and object
    selection. Arm side: camera setup/check tool, record/train/evaluate wrappers
    around LeRobot, calibration and teleop launchers, hardware check scripts.
    Setup and launcher reference in HARDWARE.md.
    [calibrate.py, capture.py, fixation.py]
2026-10-17 Add arm runner, scripted-pick fallback and training augmentation
    - arm/runner.py: a long-blink selection runs that object's ACT policy
    (lerobot-rollout) or the scripted pick, then glides home; hooked into
    gaze.cmd --arm with status on screen; policies listed in arm/policies.json
    - arm/motion.py + home.cmd: shared eased moves and a saved rest pose
    - arm/scripted.py + scripted.cmd: ikpy kinematics on the SO-101 model
    (arm/so101/so101_new_calib.urdf from TheRobotStudio/SO-ARM100),
    table-to-robot calibration by touching the markers, top-down pick and drop
    - train.cmd: LeRobot image augmentation on by default (--no-augment to skip)
    - gaze/objects.json: drop (bowl) position for the scripte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
    [so101_new_calib.urdf]
2026-10-17 Gaze calibration: black-disc target and best-of affine/quadratic fit
    ArUco markers are only ~30 px (4 px per cell) in the 240x240 front camera and never decoded. The target is now a black disc found as the dark blob inside the bright screen, compared with its local surroundings (97% detection live). Targets sit at 20-80% of the screen, clear of the bezel. The fit keeps whichever of affine or quadratic has the lower leave-one-out error; on a screen-sized calibration affine halved it (18.1 -> 9.8 px).
    [calibrate.py, mapper.py, target.py]
2026-10-17 Reconnect the Wi-Fi front camera when its stream stalls
    FFmpeg waited 30 s on a stalled MJPEG read, freezing the gaze view. Reads now time out after 2 s and the capture thread reopens the stream; the gaze view shows when the front camera is reconnecting.
    [capture.py, live.py]
2026-10-17 Un-mirror the Wi-Fi front camera
    Board B's OpenIris stream is mirrored left-right, which also stops the table ArUco markers from decoding. Frames are flipped back in the capture thread and in front.cmd; an existing calibration converts by mirroring its front-camera points.
    [capture.py, live.py]
2026-10-17 Table gaze calibration, wave test action, blink-only mode
    - calib.cmd --mode table: a phone showing gaze/phone_target.png lies on the board; look at its dot, SPACE per spot, f to fit. The laptop window stays dark so it isn't mistaken for the phone.
    - gaze/target.py: checks every bright screen-like region, sizes its local-contrast window to the screen, and rejects glare patches and faint blobs (no false hits on frames without a screen; synthetic phones located within 1 px).
    - arm runner: 'wave' action needing no table or training.
    - gaze.cmd --blink-action wave: any long blink runs that action, to test eye -> arm today.
    [calibrate.py, live.py, target.py]
2026-10-17 Connect gaze to the team intent agent: dwell pre-hovers, long blink descends
    gaze/intent_bridge.py extends look_intent.shell.Shell without changing it: a completed dwell makes an object confirmable instead of descending, the pre-hover is held while the eyes are shut, and a long blink logs fixation_fired (method long_blink) and grasps. arm/intent_arm.py is the real arm adapter (request_prehover / cancel_prehover / grasp) on its own worker thread, logging arm_descend at the actual descent; scripted pick split into hover + pick_from_hover with a grip check. gaze.cmd --intent [--chalk] runs it and writes logs/session-*.jsonl for intent/evals. Offline test: pre-hover on dwell, held through the bl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
    [intent_bridge.py, live.py]
2026-10-17 Camera relay: share every camera with other machines (YOLO on the MacBook)
    streams/relay.py opens the side, wrist, eye and front cameras once and serves each as MJPEG over HTTP to any number of viewers, with snapshots and an index page. Arm cameras are found by USB model and skipped if unplugged (never swapped for another camera), opened wrist-first, rotated as in arm/cameras.json; Board B is un-mirrored and reconnects on stalls. streams/mac_yolo.py runs YOLO on the streams on the MacBook. gaze tools only un-mirror Board B's own stream, so they can read the relay too. Tested: three USB streams at ~11 fps read together, two viewers on one stream at 13 fps each.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
    [capture.py, live.py]
2026-10-17 Real table layout, granola + pipe cleaner, hand-over instead of a bowl
    - scene/config.json: markers at the measured 619.6 x 369.8 mm corners
    - TableTracker retries on a 2x upscale when small markers are missed
    - objects.json: granola bar and pipe cleaner, both scripted picks
    - scripted calibrate touches markers and object spots, s skips unreachable ones
    - no drop spot: lift high above the spot, hold 3 s, release
    [markers.py]
2026-10-17 Shallower table (far markers 9.5 in out), drop spot recorded by touch
    - scene/config.json: markers 0 and 1 moved in to y = 241.3 mm so the arm reaches all four
    - scripted calibrate fits on the markers only (object spots are camera estimates)
    - after the markers, touch the drop spot; its table position is saved to objects.json
    (n = no drop spot, items are handed over)
2026-10-17 Arm table calibration: save touches, affine + tilted-plane fit, diagnostics
    The rigid fit came out at 23 mm on the real arm. Calibration now saves every
    touched point, reports per-point error, tip heights and measured-vs-arm marker
    spacing, and moves with an affine map plus a table plane (4+ points), which
    absorbs smooth joint-offset errors in the arm model.
2026-10-17 Arm table fit follows the markers exactly; teach object spots by touch
    The real arm's model is off with reach (far marker pair 596 mm apart, near pair 561 mm,
    both measured 620), a trapezoid an affine map can't follow (8.7 mm). Moves now use a
    homography through the touched markers; the affine error stays as the reported check.
    scripted.cmd teach <object|drop> records a spot by touching it with the limp arm.
2026-10-17 Scripted picks match a taught grip angle (wrist roll)
    The first real pick reached the right spot with the jaws turned the wrong way:
    IK only constrained "point down" and left the wrist roll free. teach now saves the
    jaw heading in the table frame as "yaw" in objects.json; picks roll the wrist to it
    (half-turn symmetric, nearest the roll centre) and re-solve the position with the
    roll held, since the tip sits off the roll axis.
2026-10-17 Teach records grip height per object; reachable hand-over height
    teach now saves grasp_mm (where the jaws close) alongside position and grip angle,
    and picks hover/hand over relative to it. Pointing straight down the arm tops out
    around 13 cm above the table, so the hand-over drops to 12 cm and teach warns when
    an object's approach can't be reached.
2026-10-17 Markers 0 and 1 are physically swapped since the far pair moved: 0 far-right, 1 far-left
    The side camera's 2-marker fit drops from 61.7 mm to 5.4 mm with the swap.
2026-10-17 Live side-camera check for aiming and focusing (markers read, lock, sharpness)
2026-10-17 Side camera holds its all-marker table fit while visible markers agree
    The far markers are a few pixels per cell and flicker in and out. A static
    TableTracker keeps the last fit made with every marker in view, re-checks it
    against whatever markers are visible each frame, and drops it if they disagree
    (camera bumped). side_check uses it and saves a snapshot every second.
2026-10-17 Live object detection: side camera finds objects anywhere on the board
    - scene/detect.py: coloured blobs on the white board, boxed in table mm (position, long
    axis, size), tracked over frames; per-class grip offset, position correction and colour
    learned from a teach (gaze/classes.json)
    - scene/naming.py: YOLOE open-vocabulary names, prompt embeddings cached in models/
    - scene/live_objects.py + objects.cmd: owns the side camera, writes gaze/objects.json
    - teach also records the class's grip in classes.json
    - gaze/live.py follows objects.json as it changes; --yolo labels the front camera view
    - marker layout: 2 is near-left and 3 near-right (all-four fit 5.3 mm); this replaces
    the earli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
    [detect.py, live.py, live_objects.py, markers.py, naming.py]
2026-10-17 Detection: skip marker squares, reject board-coloured shadows, merge pieces of one object
    First live run listed 9 objects for 3: tinted marker edges, the arm's shadow and the
    granola wrapper's separate colours. Now 2 clean boxes on the same frame.
    [detect.py]
2026-10-17 Detection: inhaler class, colour hints, no duplicates, board-only, restart-proof lock
    - classes.json: thai_inhaler ("small green tin"), side-camera colour hints for all classes
    - duplicate tracks of one object merge; brief blobs (hands) aren't listed
    - only blobs on the white board itself count (the wooden table read as a pipe cleaner)
    - a tall object's top and base (same colour, stacked in the image) merge into one
    - search out to the board's edge past the far markers (the inhaler sat there)
    - the side camera's all-four table fit is saved and reloaded on restart
2026-10-17 Picks at any bar angle across the board: low straight-down approach, both wrist half-turns
    - far out the arm can't point straight down from the full hover height: come in high with
    the gripper tilted if need be, then a straight-down approach as high as it reaches
    (down to 8 mm over the grip), the same in reverse on the way up
    - the wrist tries every half-turn that grips the same before giving up
    - seeds are kept inside the URDF joint limits (the solver refuses one outside)
    Sweep of 12 bar angles: all reachable over the middle band; the board's left/right ends partly.
2026-10-17 Live view shows where the arm can pick: shaded reach map, OUT OF REACH objects
    arm/reach.py solves a pick's full plan without moving (0.2-0.9 s). Per object it runs
    in the background whenever an object moves or turns; objects.json gets reachable.
    A 50 mm reach map over the board (share of 3 grip angles per cell) fills from the
    middle out and is cached until the table calibration changes. M toggles it.
2026-10-17 Detection: dominant-hue colours, smoothed and re-checked; learn from the main body
    The granola bar learned a red hue (its wrapper end) with a grip offset from that
    piece, and a hand merging in one frame renamed it 'inhaler' for good. Colour is now
    the histogram peak, smoothed per track and re-checked every frame; learning takes the
    biggest established object at the taught spot; new tracks can't merge away old ones.
    granola_bar's bad learn is cleared (hue reset to the measured green; re-teach it).
    [detect.py]
2026-10-17 Picks keep the object's spot from hover time for the descent
    Over the object the arm hides part of it from the side camera, so the live spot
    and angle drift (or the object drops out) right when the descent re-read them.
    Hover now locks the entry it used (2 min) and prints it.
2026-10-17 Identify objects by colour mix and size, voted over frames
    Far from the side camera the granola wrapper's green washes out and its red end
    dominates - one hue said pipe cleaner. Each blob now carries a saturation-weighted
    hue histogram; classes have a signature (colour mix + footprint area, learned at
    teach); the match score is shared colour minus a size-mismatch penalty, smoothed
    per track, with YOLO as a bonus. Bar at the far spot: granola 0.55 vs pipe cleaner 0.21.
2026-10-17 Picks cancel servo sag at each waypoint and park + relax afterwards
    Read after 5 missed picks: servos at 56-63 C from holding the arm up between
    picks, elbow 4.9 deg and shoulder 2.4 deg short of their goals under load
    (1-2 cm at the gripper). Each waypoint now nudges the arm joints' goals by
    what they're still off (3 rounds, at most ~9 deg); scripted pick ends at home
    with torque off so they cool.
2026-10-17 Session data 2026-10-17 for the team: eye recordings, gaze/arm calibration, scene
    data/2026-10-17/: pupil-detector recordings (blink, spread and extremes tests),
    detector config, gaze calibration, follower/leader calibrations, rest pose, the
    arm's table calibration with its touched points, side-camera table fit, reach
    map, object classes with learned colours, camera snapshots, and the env's
    package list. README says what each file is and where it lives. No LeRobot
    episodes were recorded (picks are scripted). Eye close-up left out (public repo).
    [eye_extremes.csv, eye_test2.csv, eye_test3.csv, eye_test4.csv, eye_test5.csv, eye_test6.csv]
2026-10-17 STOP from any window, pick log, mouse-as-gaze test mode, venue checklist
    - STOP: s/space in the objects, gaze and mouse windows, or stop.cmd. Every glide and
    sag-correction step checks it and freezes the arm in place (torque stays on); homing
    never drops the arm when stopped or failed. A new command clears it.
    - logs/picks.jsonl: one line per grasp (object, spot, angle, low approach, held);
    pick_stats.cmd summarises success per object.
    - mouse_gaze.cmd: top-down board map, the pointer is the gaze, b long blink, d double
    blink - the real BlinkShell + IntentArm, so everything but the glasses is tested.
    - policies.json: inhaler and water_bottle are scripted picks too.
    - VENUE.md: re-set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
    [live.py, live_objects.py, mouse_gaze.py]
2026-10-17 Eye viewer finds Board A by name and falls back to Media Foundation
    Its camera number changes whenever USB devices come and go (it went 3 -> 1 when the
    arm cameras dropped off), and DirectShow sometimes refuses it after a replug.
2026-10-17 Gaze tools find the glasses cameras themselves (--eye auto, --scene auto)
    Board A by its USB camera name (its number keeps changing), Board B by its Wi-Fi
    MAC in the laptop's ARP table (its IP changes with the hotspot; no probe, since
    it serves one viewer at a time). DirectShow falls back to Media Foundation.
2026-10-17 Board B finder sweeps the hotspot ranges when it isn't in the ARP table yet
    On a hotspot the laptop doesn't run (the iPhone's) it only learns Board B's
    address after talking to it. Also: two same-named hotspots on at once made
    Board B hop between them (4 new IPs in an hour, 0.2-1.7 fps); one hotspot: 13.9 fps.
    [capture.py]
2026-10-17 Bigger fixation dot (white-ringed) on the calibration targets; eye box for the new camera module
    [target.py]
2026-10-17 Pupil detection relative to the surroundings (local_sigma) for the new eye camera
    With the new module the pupil sits against the soft dark band of lashes and upper
    lid; any threshold that caught the pupil also caught the band, the merged blob
    touched the box edge and was rejected - pupil found in 7/21 frames while looking
    straight ahead. Subtracting a 12 px blur first leaves the compact pupil and fades
    the band: 21/21, on the pupil in every frame.
2026-10-17 Side camera: one visible marker no longer confirms the held table fit; re-save the hold on every all-four view
    A bumped camera kept passing the single-marker check and reported object positions
    from a stale mapping. Two agreeing markers are now needed; every all-four view
    (at most every 10 s) refreshes the saved hold.
    [markers.py]
2026-10-17 Detection: count darker coloured pixels (VAL_MIN 25) - the granola wrapper reads ~45 in the arm's shadow
2026-10-17 Detection: dark, off-tint pixels count as object (teal wrapper far from the camera)
    From the final side-camera spot the granola body reads sat ~60, val ~90 - under the
    'coloured' bar, so only its label and red tab were found: two unnamed pieces.
    Pixels clearly darker than the board (< 60% of its brightness) with a hue >30 away
    from the board's tint now count too; the arm's black parts and shadows sit within
    ~20 of the tint and stay out. Bar: one 138x62 mm box, centre steady to ~2 mm.
2026-10-17 New object class: foam (colour mix + size from the side camera), pickable
2026-10-17 Table calibration writes a status snapshot each second; foam taught and learned
    - gaze/calibrate.py: logs/calib_status.txt + calib_view.jpg + calib_eye.jpg every
    second, so the state can be checked while the calibration holds both cameras
    - classes.json: foam's grip height, colour signature and offsets from its teach
    - objects.json: current live scene
2026-10-17 Table calibration: phone-only target detection, steady-spot checks, running fit error
    The table calibration came out at 88 px: the target finder also "saw" targets in
    dark UI on the laptop screen and in ceiling lights (over half the frames with no
    phone in view), and spots were medians over whatever came in.
    - find_target(phone=True): the disc must sit centred in a tall bright rectangle and
    span ~80% of its width (laptop-screen shapes and lights fail); found at 25-70 px
    and any rotation in tests
    - a spot is redone unless most pupil samples agree within 4 px and most target
    detections within 8 px
    - from spot 5, a spot that disagrees with the earlier ones by >30 px is flagged
    (r drops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
    [calibrate.py, target.py]
2026-10-17 Gaze cameras reconnect after a USB board reset too (re-found by name)
    Board A resetting killed the calibration's eye camera for good: only the Wi-Fi
    stream reconnected. USB sources now reconnect after ~1 s of failed reads,
    re-resolving 'auto' since the camera number can change.
    [capture.py]
2026-10-17 Screen calibration targets back to a solid disc with a tiny dot (big ringed dot only on the phone target)
    The bigger white-ringed dot broke up the on-screen disc in Board B's blurry view:
    0 front-camera detections at all 9 points.
    [target.py]
2026-10-17 Board B: our own MJPEG reader that skips corrupt frames instead of FFmpeg aborting
    On a weak Wi-Fi link Board B sends damaged JPEGs ('huffman table decode error');
    FFmpeg then hit an assertion in libavformat and killed the whole calibration.
    MjpegCapture cuts frames out of the HTTP stream by their JPEG markers and decodes
    them one by one, dropping any that won't decode; reconnects work as before.
    Live: 14.5 fps, no reconnects.
    [capture.py]
2026-10-17 Target finder: accept discs down to 0.8% of the screen's area (was 3%)
    With a full-screen white canvas the whole laptop screen counts as the screen, and
    the 0.22-height disc covers ~1.5% of it: visible in every Board B frame, rejected
    by the size rule (0 points). No new hits on frames without a target.
2026-10-17 Eye viewer shows a focus number; screen calibration logs why eye samples are rejected
    - eye/live.py: Laplacian sharpness inside the eye box (smoothed) and the best so far,
    to turn the lens to its peak
    - gaze/calibrate.py (screen): per point, the reasons eye frames weren't usable and
    an eye frame saved to logs/ - the last run was mostly 'no pupil' on a blurry eye
2026-10-17 Screen calibration: only the biggest bright area (the laptop screen) can hold the target
    Two left-side targets were 'found' at the far right edge of Board B's view, on some
    other bright thing, and took the fit from 6.0 px to 55 px. Phone mode still looks at
    up to 3 bright areas.
2026-10-17 Head camera: markers stay usable for 0.6 s after decoding (Board B sees them one at a time)
    Board B decodes the 5 cm markers in ~1 of 3 frames, one at a time, never two together;
    remembering each for 0.6 s lets near-still head poses combine them. Not enough at the
    current marker size (no lock in tests) - bigger markers or head-fixed mapping needed.
    [live.py, markers.py]
2026-10-17 Big head-camera markers: per-marker sizes, printable 150 mm ids 4-7, positions found by the side camera
    Board B shows the 50 mm markers at 8-10 px and decodes them in ~1/3 of frames, one
    at a time - never enough for a table fit. 150 mm markers are ~40 px and decode even
    blurred (30-55 px tested).
    - TableConfig.sizes: an edge length per marker id (default marker_size_mm)
    - scene/make_big_markers.py: markers_big_letter.pdf, one marker per Letter page
    - scene/add_big_markers.py (+ .cmd): locates them with the locked side camera and
    adds their table positions to scene/config.json - no measuring
2026-10-17 Add optional Grok confirmation, Chalk routine priors and Factory workflow
    [grab_log.csv]
2026-10-18 Add Run Evaluation button with custom robotics replay report
2026-10-18 Track sanitized sponsor API call receipts and append them on every call
2026-10-18 Restore original arm animations and simplify video, routines and evaluation UI
2026-10-18 Use original 3D arm for studio Phone flow and quiet live Chalk context
